tscircuit/probe-robot-arm/THIRD_PARTY_NOTICES.md

# Third-party sources

- `upstream/rack-actuator-r24/` pins tscircuit/rack-actuator revision 24 at `a0ccaf201d6f6f5f988ca64dc1a9f5e7aba931b5`. Its MIT license and upstream README are included. `model.py` loads its construction section and adapts the Z output pad locally.
- `upstream/compliant-spur-gear/` contains the original gear sources and MIT license. The shared Python rotary gear geometry adapts the open-tip tooth profile from revision 3, `37682731f360b1b327a91f8713c9e67c464a8b32`, in seveibar/compliant-spur-gear.
- Three.js and OrbitControls in `site/dist/vendor/` and `base_test_kit_v4/vendor/` are version 0.180.0, under the included MIT license. The offline viewer bundle contains these libraries.
- CadQuery and development dependencies retain their respective licenses and are installed separately.

Printed-leadscrew and T8 actuator experiments are pinned from the FLEX Site v61 source commit `417da079fe5da0ac1bed3edbbaef6dc2782e65f4`, associated with tscircuit/rack-actuator (MIT). See `upstream/leadscrew-r16/PROVENANCE.json` and `LICENSE`. The integration adapter lengthens the radial stage and supplies full-depth NEMA17/NEMA14 motor configurations; T8 widened mounting patterns are inferred locally.

The active actuator source is rack-actuator revision 24, commit cc86a8e20de12db4f5eda797278d3ff07537a772, retained in upstream/leadscrew-grid31 with its original license. The arm applies full-depth motors, a NEMA14 radial motor, direct threaded lid attachment and matching support locally.
