tscircuit/probe-robot-arm/upstream/compliant-spur-gear/compliant_gear_v2.scad

// Compatibility entry point. Current open-tip geometry is defined here:
include <compliant_gear.scad>
