tscircuit/probe-robot-arm/(commit log)

2026-11-06 Add modular probe arm CAD, four angled press-fit rollers, and interactive viewer
    [HARDWARE_LIST.csv, compliant_gear.scad, compliant_gear_v2.scad]
2026-11-07 Lighten rotating deck with rounded cutouts and retained mounting lands
2026-11-07 Adjust roller track fit and add isolate, hide and show-all controls
2026-11-07 Add four longitudinal relief slots to each bearing axle
2026-11-07 Move relief slots to the central 6002 spindle and restore roller axles
2026-11-08 Integrate wide printed-leadscrew actuators with shared T8 mounting patterns
2026-11-08 Mount radial actuator upright and align reinforced carrier with selectable Z widths
2026-11-08 Shift radial stage rearward and reinforce Z support with controller clearance
2026-11-08 Flatten Z-support print face and add rounded weight-reduction cutouts
2026-11-08 Add symmetric Z braces and compact the balanced radial stage
2026-11-08 Mount radial lid directly to inverted Z stage and lower PCB table
2026-11-09 Adopt 31 mm actuator grids and open, spread deck mounts
2026-11-10 Add rigid 16:1 internal-gear arm variant and viewer
2026-11-10 Compress CAD transport and share identical radial print assets
2026-11-10 Triangulate Z tower with flat-printed rear braces and keyed deck feet
2026-11-10 Add socketed hollow backbone variant with flat printed shells
2026-11-10 Revert "Add socketed hollow backbone variant with flat printed shells"
    This reverts commit 2f9087cb98d574535aa831081f741a65d04355d1.
2026-11-10 Enlarge rigid base to a 296 mm 264T ring and 22:1 drive
2026-11-10 Replace tower struts with a perforated side-mounted front frame
2026-11-11 Tie the front Z frame to the wide base with printed struts
2026-11-11 Center the front and rear struts and distinguish printed part colors
2026-11-11 Extend center struts to the deck edge and unify actuator colors
2026-11-11 Brace the cage grid to the rear and analyze print support and stiffness
